tracelabs-pcb/4in1-esc-pcb/screenshots/pcb_3d.png

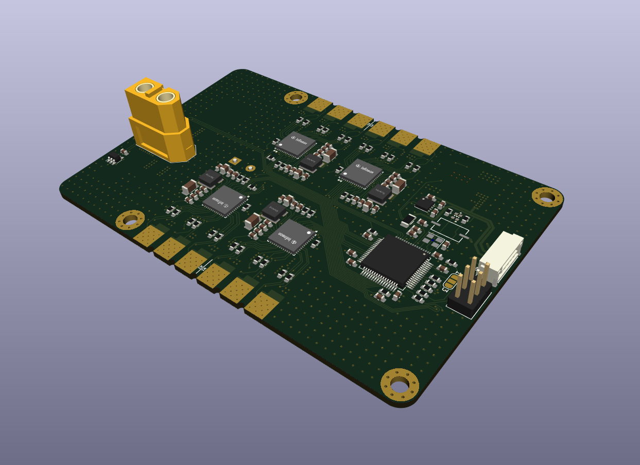
screenshots/pcb_3d.png
