tracelabs-pcb/4in1-esc-pcb/screenshots/pcb_all_layers.png

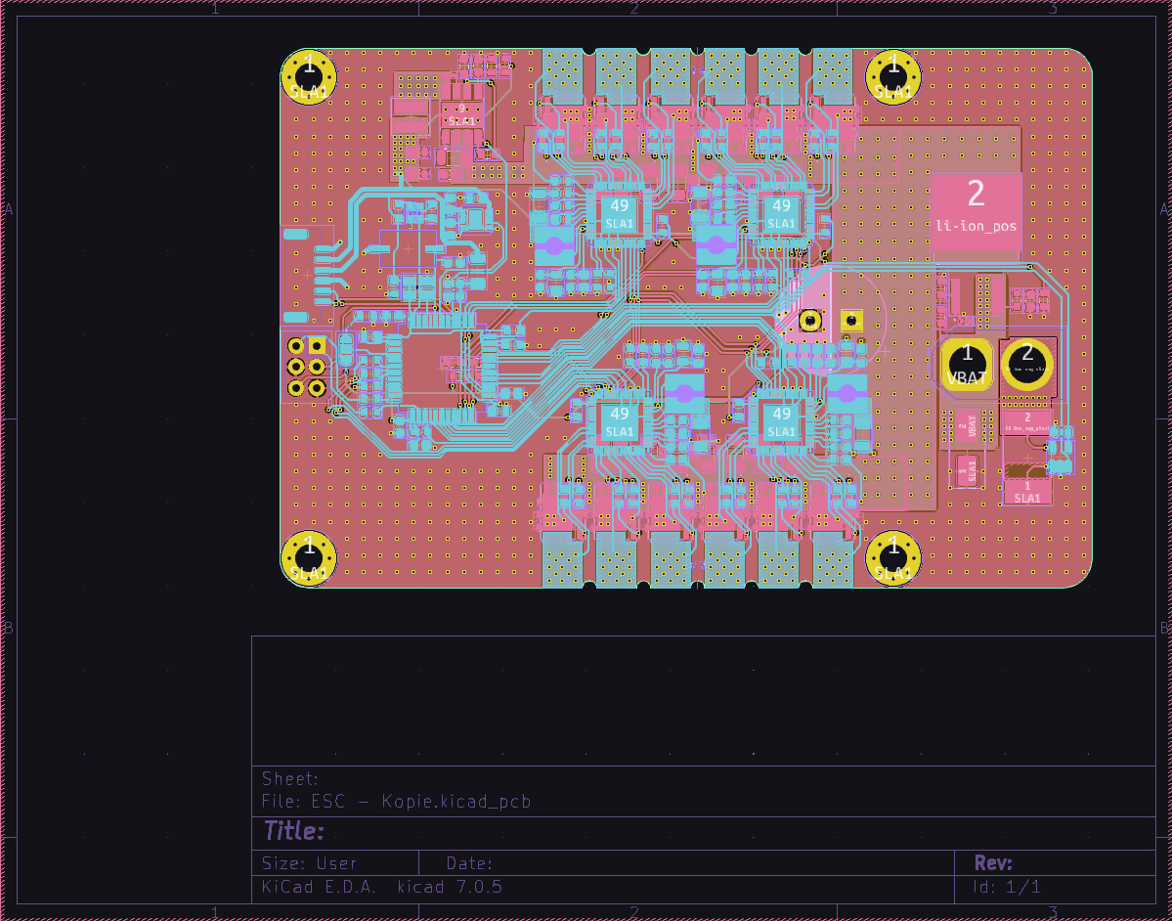
screenshots/pcb_all_layers.png
