tracelabs-pcb/4in1-esc-pcb/screenshots/pcb_routing.png

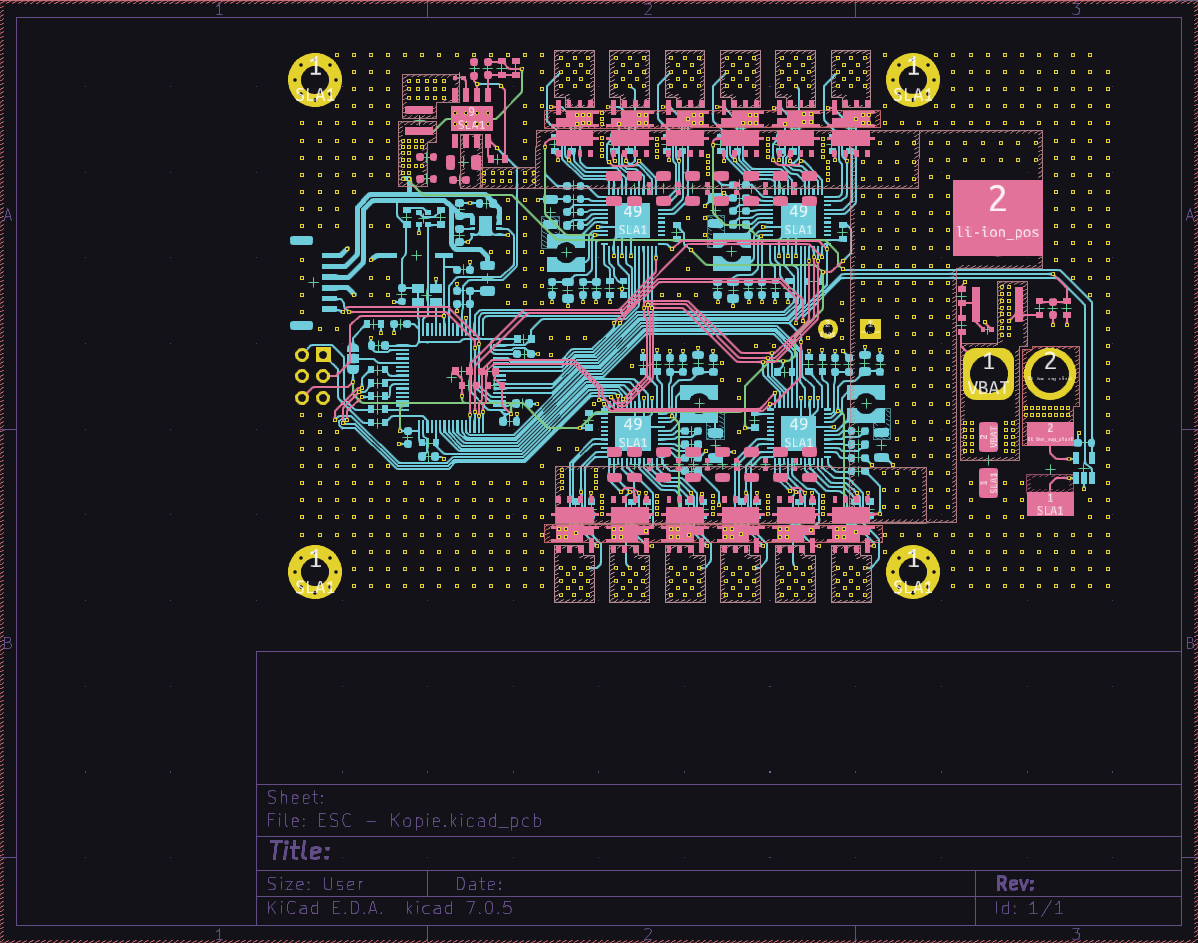
screenshots/pcb_routing.png
