tracelabs-pcb/4in1-esc-pcb/screenshots/schematic_gate_driver.png

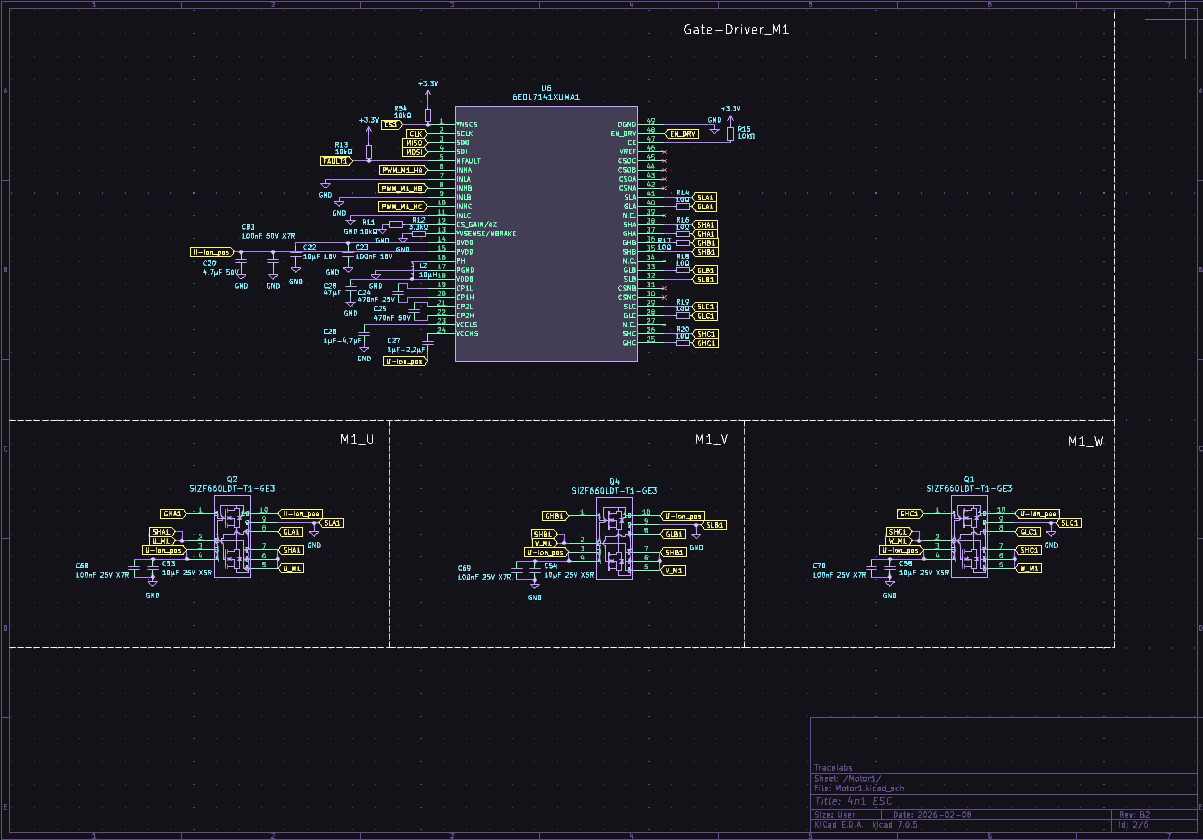
screenshots/schematic_gate_driver.png
