tracelabs-pcb/4in1-esc-pcb/screenshots/schematic_supply.png

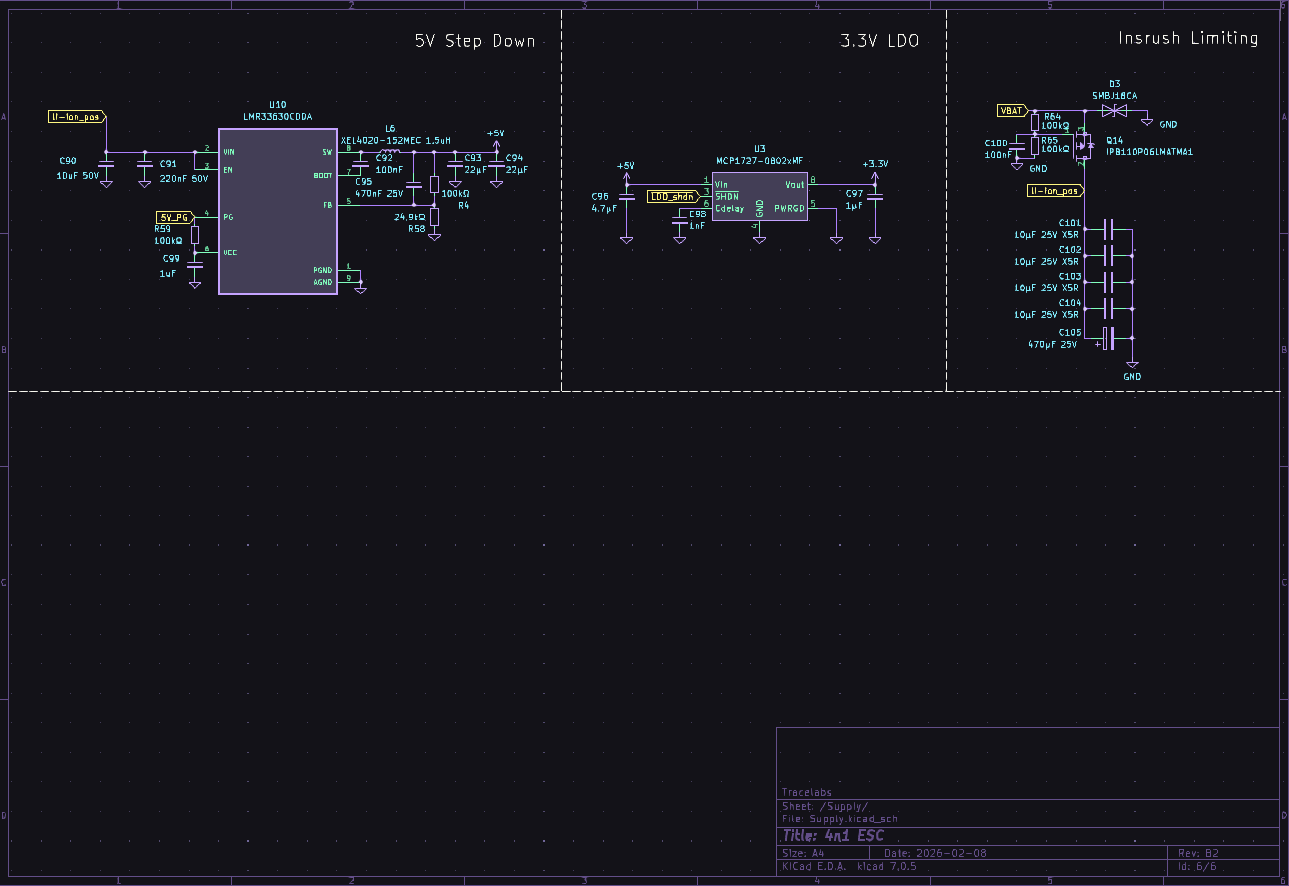
screenshots/schematic_supply.png
