tracelabs-pcb/4in1-esc-pcb/screenshots/schematic_top.png

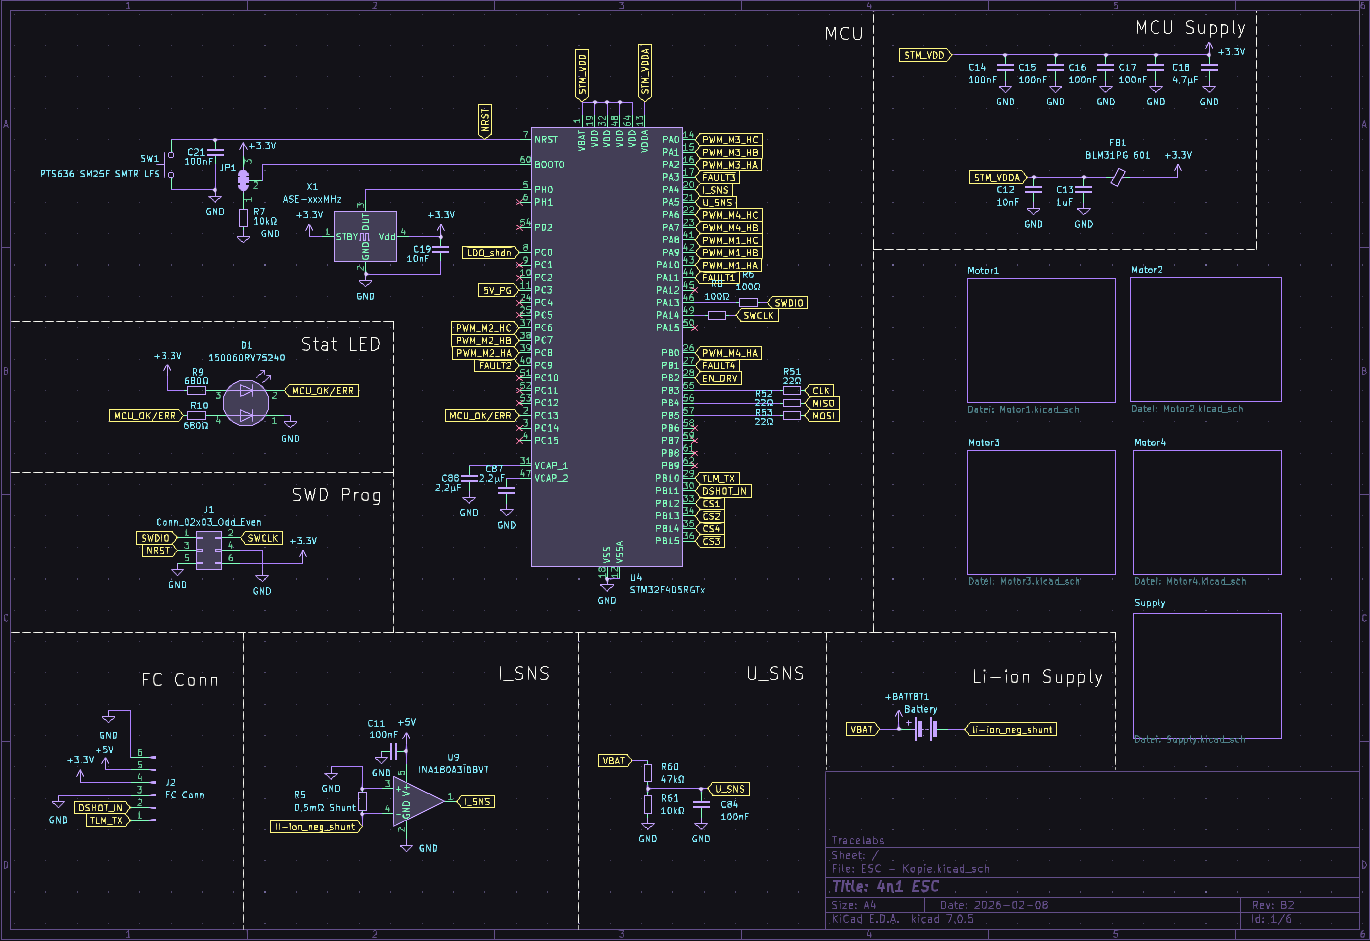
screenshots/schematic_top.png
