tracelabs-pcb/4in1-esc-pcb/(commit log)

2026-03-27 Add 4-in-1 ESC project README
2026-07-16 Add bare-metal STM32F405 firmware for Motor 1 sensorless commutation
    Implements 6-step trapezoidal BEMF commutation matching the described
    hardware: TIM1 3-channel PWM on PA8/9/10 (INHC/INHB/INHA), EXTI6/7/8
    zero-cross capture on PB6/7/8 with per-step edge-direction filtering,
    TIM2 free-running 1MHz timestamp base, TIM3 one-pulse 30-degree
    commutation delay, eRPM per spec (60/(6*dt)), and a SPI1/PB12 driver
    transaction layer for the 6EDL7141. Register-level (no HAL/CubeMX
    dependency), builds clean with arm-none-eabi-gcc under -Wall -Wextra.
    6EDL7141 3PWM-mode register configuration and the floating-phase
    behavior are left as explicit stubs (see firmware/README.md) since the
    exact register m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
2026-08-10 Configure 6EDL7141 for 6PWM mode based on real datasheet register map
    Fetched and parsed the actual 6EDL7141 datasheet (Rev 1.02) the user
    provided. Confirms the SPI frame format/CPHA already implemented was
    correct (24-bit: 1 R/W + 7-bit addr + 16-bit data, mode 1, matches the
    datasheet's own worked SPI example byte-for-byte).
    Critical correction: with INLx hard-wired to GND on this board, PWM_MODE
    must be 6PWM (register PWM_CFG @0x13 = 0x0000, also the POR default),
    not 3PWM. Per the datasheet truth tables, 3PWM mode ignores INLx and
    always drives the complementary low side, which would clamp the
    "floating" sensing phase to GND instead of letting it float - breaking
    the external LM2901/VS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
    [commutation.h, edl7141_spi.c, edl7141_spi.h, main.c]
2026-08-10 Restructure firmware to STM32CubeIDE project layout (Core/Inc, Core/Src, Core/Startup)
    Renamed inc/ -> Core/Inc, src/ -> Core/Src, startup/ -> Core/Startup,
    and moved the linker script to the project root as
    STM32F405RGTX_FLASH.ld, matching the layout STM32CubeIDE generates for
    a new STM32 Project. Adjusted Makefile paths accordingly (still builds
    clean standalone via `make`). Added step-by-step CubeIDE import
    instructions to firmware/README.md.
2026-08-10 Add open-loop startup ramp and EN_DRV (PB2) control so the motor actually spins
    User confirmed: CE is hardwired high via pull-up (no MCU action needed),
    EN_DRV is on PB2, and PB6/7/8 are LM2901 comparator outputs 1/2/3.
    Adds gpio_en_drv_set() and sequences it after edl7141_configure_pwm_mode()
    in main.c (PWM_CFG is Standby-only, must latch before EN_DRV goes high).
    Adds commutation_open_loop_start(): blocking align + linear-ramp stage
    entirely independent of BEMF/comparator wiring, then a non-blocking
    fixed-rate cruise via TIM3, so the motor turns without depending on the
    still-unconfirmed comparator-to-phase mapping. main.c now runs this by
    default. commutation_handoff_to_closed_loop() is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
    [commutation.c, commutation.h, gpio_config.c, gpio_config.h, main.c]
2026-08-10 Fix HardFault (BusFault UNSTKERR) seen during open-loop bring-up
    Root causes found via CFSR=0x00000800 (BFSR.UNSTKERR) / HFSR FORCED,
    captured while debugging on real hardware:
    1. EXTI6/7/8 (comparator) interrupts were unmasked from commutation_init()
    onward, including during open-loop PWM operation. The 1nF/~7kHz phase
    filter can't suppress 20kHz PWM edges, so the comparators chatter on
    every switching transition - tens of thousands of spurious
    EXTI9_5_IRQHandler calls per second while open-loop is running. IMR is
    now left masked until commutation_handoff_to_closed_loop() unmasks it.
    2. The linker script discarded libgcc.a entirely (/DISCARD/), while the
    build uses -mflo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
    [commutation.c, zero_cross.c]
2026-08-10 Add plain-integer bring-up checkpoints for debugging without register decoding
    Adds g_debug_checkpoint (main.c stage reached), g_debug_ramp_i (last
    open-loop ramp iteration reached), g_debug_tim3_count and
    g_debug_exti_count (ISR fire counts) as volatile globals, readable in
    the debugger's Variables/Expressions view after a crash - no CFSR/HFSR
    hex decoding needed to see how far execution got.
    Paused further firmware changes here: live bring-up now points at a
    hot gate driver IC, which looks like hardware damage (plausibly from
    the earlier multimeter short-circuit incident) rather than a firmware
    bug, so hardware inspection takes priority before more software
    iteration.
    [commutation.c, commutation.h, main.c]
2026-08-11 Reduce main.c to a minimal SPI-only bring-up test with PC13 status LED
    Per request: test incrementally instead of bringing up PWM/EN_DRV/
    commutation all at once. New main.c only initializes SPI1 and reads
    DEVICE_ID from the (freshly replaced) Motor 1 gate driver - no PWM, no
    EN_DRV, no EXTI. PC13 lights green (HIGH) if the device answers
    correctly, red (LOW) otherwise. Added GPIOC support (base address,
    RCC_AHB1ENR_GPIOCEN, GPIOC pointer) to the register header for the LED.
    The full open-loop commutation main.c (with the checkpoint counters)
    is still in git history on this branch and can be restored once SPI
    bring-up is confirmed working.
    [main.c]
2026-08-11 Bring-up step 2: verify SPI writes reach the 6EDL7141, not just reads
    Writes a distinct non-zero test pattern to PWM_CFG and reads it back
    before writing the real desired 6PWM value - using 0x0000 directly
    for the test wouldn't prove anything since that's also the register's
    power-on-reset value. Still no EN_DRV/PWM/EXTI touched.
    [main.c]
2026-08-11 Bring-up step 3: enable EN_DRV and check FAULT_ST, LED blink convention
    Extends the incremental bring-up: after the SPI read/write checks
    (now fail-fast with solid red instead of a combined pass/fail), writes
    the real 6PWM PWM_CFG value, raises EN_DRV, waits ~20ms for the charge
    pumps to settle, then reads FAULT_ST over SPI. Still no PWM/TIM1, no
    EXTI - MOSFET gates see nothing from the driver.
    LED convention going forward: solid red = failed here, stop; blinking
    green = this step passed; solid green reserved for the step after.
    Raw FAULT_ST exposed as g_debug_fault_st for inspection on failure.
    [main.c]
2026-08-11 Disable unused current-sense amplifiers to fix spurious CS_OCP_FLT on phase B
    Root cause of the FAULT_ST=0x0082 seen during bring-up: CSAMP_CFG
    resets to 0x0028, which enables only phase B's internal current-sense
    amplifier (CS_EN=b010) - an unusual reset default, verified against
    the datasheet register table. This board has no shunt resistors wired
    to the driver's CSNx/CSOx pins at all (confirmed unbeschaltet - a
    separate INA180A3 handles total board current via the STM32 ADC
    instead), so the floating phase-B amplifier's OCP comparator trips on
    noise. Per the datasheet's own recommendation ("disable current sense
    amplifiers that are not used"), main.c now writes CSAMP_CFG with
    CS_EN=000 bef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
    [edl7141_spi.c, edl7141_spi.h, main.c]
2026-08-11 Clear stale FAULT_ST bits after EN_DRV instead of only reading once
    FAULT_ST bits stay latched-until-cleared once tripped regardless of
    latch configuration (per datasheet), so BK_OCP_FLT observed at
    0xE000... FAULT_ST=0x0080 was very likely a one-off startup transient
    (possibly a side effect of the CS_OCP_FLT false trigger before the
    CSAMP_CFG fix) rather than an ongoing fault. main.c now records the
    pre-clear value (g_debug_fault_st_before_clear), writes FAULTS_CLR
    (both CLR_FLTS and CLR_LATCH), waits, and re-reads before deciding
    pass/fail.
    [edl7141_spi.c, edl7141_spi.h, main.c]
2026-08-11 Fix LED blink: was toggling green/red, now toggles green/dark
    led_set(0) drives PC13 low, which on this bicolor LED lights red, not
    off - so the "blinking green" loop was actually alternating green/red.
    Added led_off_hiz() (switches PC13 to input/Hi-Z instead of driving it
    low, so neither LED die conducts) and led_green_on(), used for the
    blink loop only; fail_forever() still uses led_set(0) for a genuine
    solid red.
    [main.c]
2026-08-11 Bring-up step 4: init TIM1 PWM at 0% duty on all channels, re-check faults
    All three TIM1 channels stay at CCR=0 (pwm_tim1_init()'s default), so
    INHx=0 on all phases - with INLx grounded in 6PWM mode that means every
    phase stays High-Z, no MOSFET gets driven. Only tests that TIM1 itself
    starts cleanly without provoking a new FAULT_ST bit (e.g. extra load
    on the buck regulator). LED: a few green/dark blinks mark step 3
    passed, then solid green if step 4 also passes; red with
    g_debug_fault_st_after_pwm_init on failure.
    [main.c]
2026-08-11 Bring-up step 5: first real switching test - 5% duty on phase A, ~3s, auto-stop
    Applies 5% duty (~420/8399 ticks) to phase A only (INHB/INHC stay at
    0%), fast-blinking green LED for the ~3s it's live so it's obvious on
    the board, then automatically returns to 0% duty regardless of what
    was observed and re-checks FAULT_ST. Meant to be watched on a scope
    (GHA-SHA differential, SHA-GND, PA10 as trigger reference, GLA-GND as
    the real shoot-through check under actual switching rather than the
    static 0%-duty check from step 4).
2026-08-12 Make step 5 repeat forever with a slow "get ready" blink before each pulse
    Previous one-shot 3s test window was impossible to reliably catch on a
    scope without perfect reset-to-trigger-arm timing (confirmed: what got
    captured was the EN_DRV/charge-pump startup transient, not the actual
    PWM switching, which only starts ~3.7s after EN_DRV in the boot
    sequence). Now step 5 loops forever: ~6s slow green blink ("arm your
    trigger now"), then the 5% duty / phase A / ~3s test pulse with fast
    blink, then a fault re-check, then back to the slow blink and repeat.
    No more racing a single window - the next pulse is always coming.
    [main.c]
2026-08-12 Add PC1 -> VSENSE/nBRAKE release, fixing driver ignoring all INHx commands
    Root cause found via scope: GHA never switches despite correct TIM1/SPI
    config, because VSENSE/nBRAKE was only tied to GND through the board's
    RSENSE pull-down (needed for DVDD 3.3V/5V selection at power-on) with
    nothing pulling it back high afterward. Per datasheet 3.9.2, the pin
    must be high for normal operation; low is read as a continuous brake
    event and the driver silently ignores INHx.
    User bodged a wire from PC1 to VSENSE/nBRAKE (no series diode - see the
    long comment in gpio_config.c for why that's safe on this board: CE is
    hardwired high so the driver's analog-sensing window only happens once
    at shared power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
    [gpio_config.c, gpio_config.h, main.c]
2026-08-12 Expose live SUPPLY_ST (UVLO/OVLO) during step 5's active pulse for debugging
    GHA still reads flat 0V during real switching even after the nBRAKE
    fix, confirmed measured directly (not the nBRAKE bodge wire). FAULT_ST
    reads clean, watchdog is off by reset default, so the remaining likely
    culprit per the datasheet's fault table is a VCCLS/VCCHS/DVDD/VDDB
    UVLO/OVLO condition - these force all MOSFET outputs to Hi-Z
    "independently of fault handling" and don't show up in FAULT_ST.
    SUPPLY_ST (0x02) is read live during every cycle of the active pulse
    window and exposed as g_debug_supply_st for inspection; all-healthy
    reads 0x003F.
    [edl7141_spi.h, main.c]
2026-08-12 Verify PWM_CFG readback, not just command it - all other enables now confirmed by hand
    EN_DRV, nBRAKE, INLx all independently confirmed correct with a
    multimeter directly at the driver pins; INHA confirmed receiving a
    clean 50us-period signal at the driver's own input pin. FAULT_ST clean,
    SUPPLY_ST all-healthy, watchdog off. The one remaining unverified
    assumption: the final PWM_CFG=0x0000 (6PWM) write was never read back
    to confirm it actually stuck, unlike the earlier test-pattern write.
    If PWM_MODE isn't really b000, INHA wouldn't mean what we assume (e.g.
    in 1PWM mode it's just a duty/frequency input, commutation pattern
    comes from other pins sitting idle) - would explain a clean input
    s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
    [main.c]
2026-08-12 Switch step 5 test pulse to phase B to isolate phase-A-specific vs driver-wide
    Every enable/config now confirmed correct (EN_DRV, nBRAKE, INLx by
    multimeter directly at the driver pins; INHA confirmed clean at the
    driver's own input pin; FAULT_ST/SUPPLY_ST/PWM_CFG/IDRIVE_CFG all
    checked via SPI) yet GHA never moves. Testing phase B instead tells us
    whether this is isolated to phase A (gate resistor, solder joint, that
    MOSFET) or affects the driver as a whole.
    [main.c]
2026-08-12 Alternate step 5 test pulse between phase A and B each cycle
    Lets GHA be re-measured at both the driver pin and the MOSFET gate
    without a reflash, right after a known-good GHB pulse for comparison.
    LED signals which phase is up next (1 blink = A, 2 blinks = B) before
    the usual slow "get ready" / fast "pulse active" blink sequence.
2026-08-12 Revert step 5 to single-phase test, now on phase A instead of B
    The alternating A/B version added an extra layer of complexity that
    wasn't needed. Back to testing one phase per flash, matching the
    original bring-up step 5 structure, but on phase A (the one still
    suspected of a local fault) instead of phase B.
    [main.c]
2026-08-12 Wire up open-loop commutation for a real motor spin test
    Replaces the single-phase bring-up test with commutation_init() +
    commutation_open_loop_start(), using the six-step commutation module
    that existed but was never called from main.c. Purely open-loop
    (fixed MCU timing, no BEMF/comparators) so it doesn't depend on the
    still-unverified comparator-to-phase mapping - matches the staged
    approach recommended in firmware/README.md. Adds continuous FAULT_ST
    polling once cruising, stopping immediately (EN_DRV off, solid red)
    on any fault.
    [main.c]
2026-08-12 Fix open-loop start hanging forever in the align delay
    commutation_open_loop_start() never returned in real testing: LED
    stayed dark forever, phase A stuck chopping at the align duty, phase C
    never touched. Root cause points to the TIM2-based delay_us() spinning
    forever - TIM2 had never actually been exercised by any prior test in
    this project (everything else uses TIM1 or plain calibrated busy-wait
    loops). Swap delay_us() to the same calibrated busy-wait technique as
    main.c's delay_approx_ms(), which every previous bring-up step has
    relied on successfully. TIM2/zero_cross_now() stay initialized for
    later closed-loop BEMF period measurement, just no longer load-bearing
    for open-loop timing.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
    [commutation.c]
2026-08-12 Add a real HardFault_Handler to diagnose the open-loop-cruise lockup
    Vector table verified correct by hand (nm + objdump -s .isr_vector):
    TIM3_IRQHandler and EXTI9_5_IRQHandler both resolve to their real
    functions, not Default_Handler - so the "stuck in Default_Handler"
    seen live after commutation_open_loop_start() reaches cruise
    (g_debug_checkpoint=901, g_debug_ramp_i=120, i.e. fully armed) is most
    likely a HardFault happening somewhere in/after the first TIM3 IRQ,
    escalating to Default_Handler only because HardFault_Handler was never
    overridden (previously just the startup file's weak infinite-loop
    alias) - indistinguishable from a genuine hang in the debugger.
    Adds SCB CFSR/HFSR/MMFAR/BF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
    [main.c]
2026-08-12 Capture the faulting PC/LR in HardFault_Handler
    Real hardware test came back with CFSR=NOCP (bit 19, "no coprocessor")
    and HFSR=FORCED - but objdump confirms zero VFP/coprocessor
    instructions exist anywhere in the built .elf (checked own code and
    every linked libgcc soft-float helper). A real NOCP fault with no
    actual coprocessor instruction in the compiled code points at a wild
    jump: execution reached a corrupted/unintended address whose bytes
    happened to decode as a coprocessor opcode, not an intentional FPU
    use. Make HardFault_Handler naked and recover the hardware-stacked
    exception frame (MSP, since this project has no PSP/RTOS) to capture
    the actual faulting PC and LR into g_debug_fault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
2026-08-12 Fix solid-red fail indicator not lighting when PC13 was mid-Hi-Z
    led_set() only wrote BSRR (output level) without forcing PC13 back to
    output mode first. If a fault/failure hit while the LED happened to be
    in its Hi-Z window (between blinks), fail_forever()'s "solid red"
    silently stayed dark instead - the pin was floating, so driving its
    ODR bit low had no physical effect. Caught by hardware testing: a
    HardFault had genuinely occurred (confirmed via the debugger) while
    the LED still looked "off", not red. Now led_set() sets PC13 back to
    output mode before writing BSRR, so the fail indicator is reliable
    regardless of what blink phase it interrupts.
    [main.c]
2026-08-12 Poll cruise stepping from main() instead of arming TIM3
    Real hardware testing hit a HardFault (CFSR=NOCP, garbage PC/LR
    pointing into unrelated code, not a real coprocessor instruction
    anywhere in the build) shortly after the first TIM3 IRQ fired once
    open-loop cruise started. Root cause not found despite checking vector
    table placement (verified correct via nm/objdump), weak/strong symbol
    resolution (verified correct), and libgcc soft-float codegen (verified
    no VFP instructions exist anywhere in the .elf) - the captured
    PC/LR look like genuine stack/register corruption, not a
    straightforwardly identifiable single bad line.
    Sidestep it for now: commutation_open_loop_start() no longer arms
    T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
    [commutation.c, commutation.h, main.c]
2026-08-14 Enable FPU coprocessor access - root cause of the NOCP HardFault
    Found via real hardware debugging: after resolving the captured
    faulting PC/LR against the user's actual STM32CubeIDE-built binary
    (not this project's own Makefile build - they differ), the
    disassembly showed real VFP instructions (vmov.f32, vldr) inside
    zero_cross_calc_erpm()/commutation_get_erpm(), called for the first
    time from main()'s cruise loop. This project's own Makefile compiles
    with -mfloat-abi=soft (verified: zero VFP instructions in that build),
    but CubeIDE's bundled toolchain apparently doesn't match that, and
    generates real hardware float instructions instead.
    The FPU coprocessor (CP10/CP11) was never enabled vi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
    [system_clock.c]
2026-08-14 Bump open-loop duty for a diagnostic test (15/25% -> 40/70%)
    Real hardware testing at the original conservative values showed zero
    measurable current increase over driver idle draw and zero physical
    response from the motor. Suspected cause: this board's INLx is
    hardwired to GND, so the low side can never be actively switched -
    return current only flows passively through a low-side FET's body
    diode, which may not build up meaningful winding current at low duty/
    short pulses. Bumping duty is a quick way to tell "too weak to move"
    (should scale with duty) apart from "something else is wrong"
    (nothing changes even here).
    [main.c]
2026-08-14 Switch to 3PWM mode as a diagnostic test for real motor current
    Datasheet confirms (Table 8, and the 6PWM section text: "MCU provides
    3 pairs of complementary PWM signals") that 6PWM mode gives the driver
    zero automatic low-side/freewheel logic - PWM_FREEW_CFG only applies
    to 1PWM/3PWM. Infineon's own 6PWM sensorless reference schematic
    (Figure 63) drives all 6 lines (INHx AND INLx) from the MCU. This
    board hardwires INLx to GND instead, so in 6PWM mode the low side can
    never turn on at all - driving one phase's high side alone leaves the
    other two phases with no return path (their low-side body diodes only
    conduct the other direction). Matches real hardware testing: zero
    current draw increa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
2026-08-14 Reduce open-loop duty for safety (40/70% -> 10/20%)
    70% duty drew 3A+ and got very hot on the actual hardware: a
    ReadytoSky 1306 3100KV motor, no propeller attached. Small stator +
    high KV means low winding resistance, so without load/cooling airflow
    and without synchronization guarantees (still open-loop), excess duty
    turns into I^2R heating rather than useful RPM. The 40/70% values had
    already served their purpose (confirming 3PWM mode gives real motor
    current, unlike 6PWM on this board) - back down to a safer starting
    point for this specific motor.
2026-08-14 Lower cruise duty to match align (20% -> 10%) for the next test
    User wants a uniform, conservative 10%/10% for the next motor test
    after the previous one overheated the motor (unloaded, ran too long
    at 70% duty - not a commutation/sync issue, board itself was fine).
    No auto time-limit added - user prefers to watch and cut power
    manually, short bursts only.
    [main.c]
